joyontadebnath/omr-digital-logic/assets/photo_6312302594889989398_y.jpg

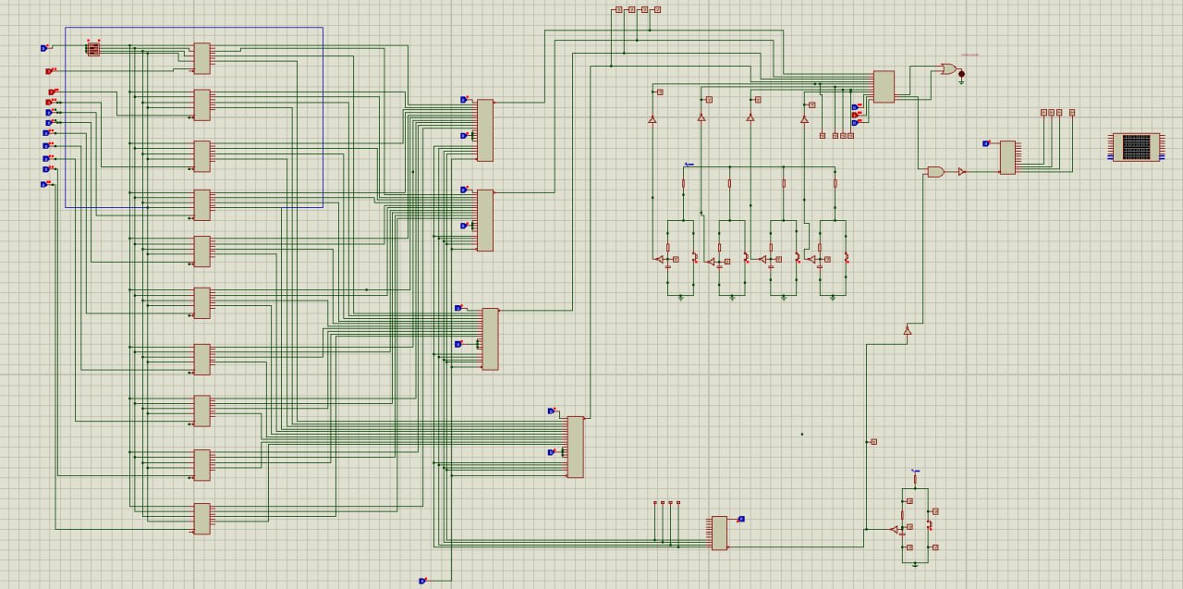
assets/photo_6312302594889989398_y.jpg
