joyontadebnath/omr-digital-logic/assets/photo_6257842383806906529_y.jpg

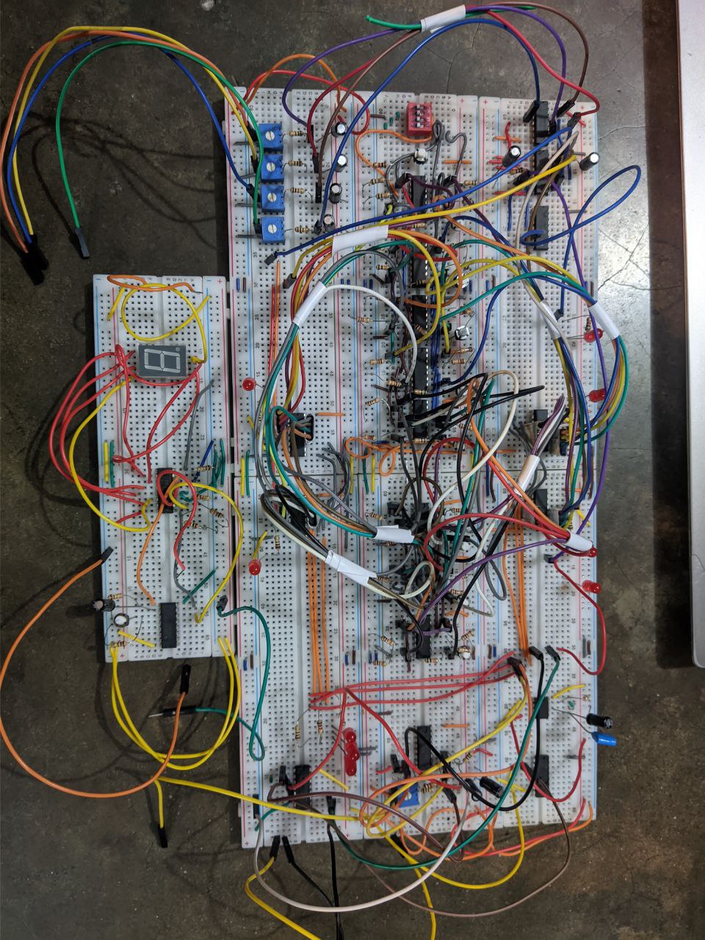
assets/photo_6257842383806906529_y.jpg
