joyontadebnath/omr-digital-logic/assets/photo_6140841530429128506_y.jpg

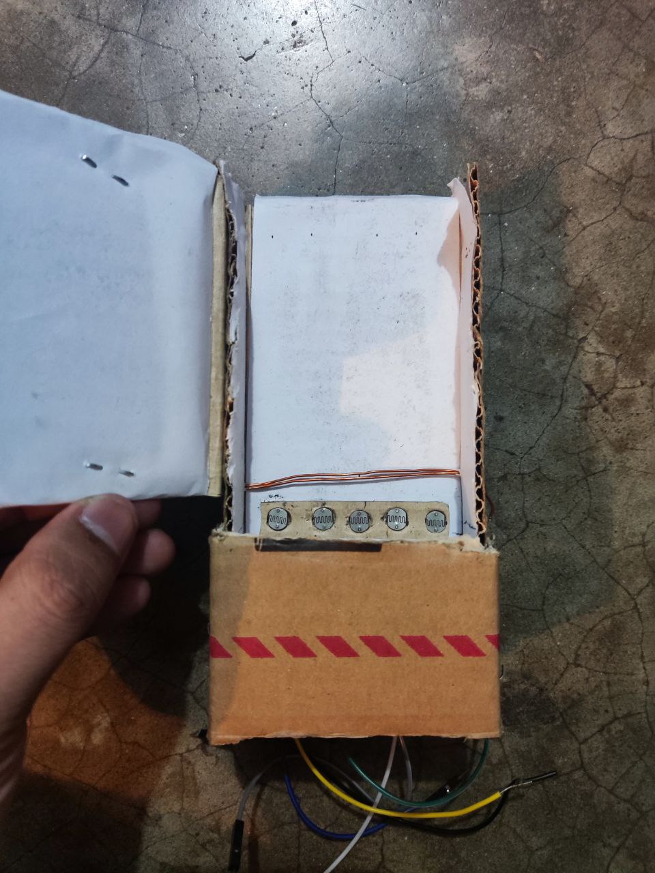
assets/photo_6140841530429128506_y.jpg
