joyontadebnath/omr-digital-logic/assets/photo_6338878456653266546_y.jpg

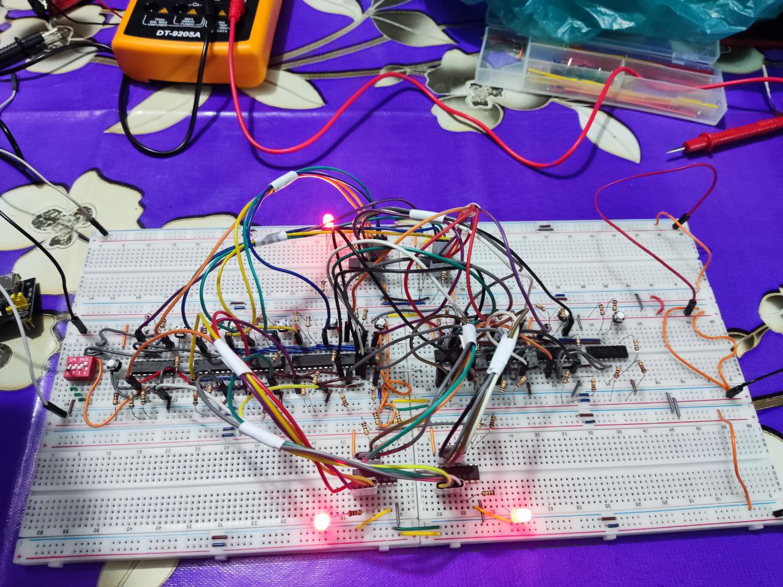
assets/photo_6338878456653266546_y.jpg
