joyontadebnath/omr-digital-logic/(list of files, drawings)

Other design files:
simulation/OMR.pdsprj
simulation/OMR_Backup2.pdsprj
simulation/OMR_Backup.pdsprj
